aweiland/Diecast-Remote-Raceway/hotwheels-start-gate-model_files/504449-hotwheels-start-gate-9a264b4c-3297-4e25-9e91-c3fe4c538997.pdf

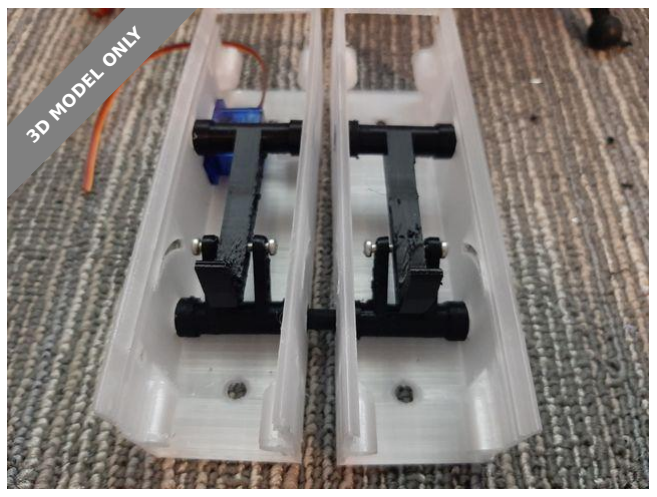
[picture p1: figure]
3D MODEL ONLY

# Summary

Based off of two other projects mostly because I didn't want to by m4

heatset inserts.

Toys & Games (https://printables.com/model?categoryId=30) | > | Vehicles (https://printables.com/model?categoryId=38)
Tags: hotwheelstrack | hotwheels

I made a few changes to a really cool project, take a look at the remote

raceway project.

Changes

Removed the need for M4 heat set inserts, I changed to holes so a M3

bolt with self tap in

I added two screw holes to the lifter, once internal pieces are

installed, tighten the screws and it will make a good connection to the

starter. I found that more than one connection between lanes would

cause binding, So I just use the stick between each of the lifters.

I redesigned the track piece, I prefer the connectors built into the

printed track pieces

I redesigned the front and back plate for a 2 lane setup, makes this

much easier to build if all you make are two lane sets.

I changed the servo mount, now uses a M3x20 set screw.

matthew s (https://printables.com/@matthews)

# Hotwheels start

# gate

VIEW IN BROWSER (https://printables.com/model/504449-hotwheels-start-gate)

updated 13. 6. 2023 | published 13. 6. 2023

1.

2.

3.

4.

5.

# Model files

I changed how it can mount to a Hotwheels mount, I combined the

parts from several Thinginverse Hotwheels clamps in this set.

3mf files showing the print orientation I used.

I have given away each build as birthday presents, so currently don't have

any complete pictures.

# This remix is based on

Diecast Remote Raceway - Starting Gate

by tqmaker (https://www.thingiverse.com/thing:4748087)

The 1/64 Diecast Car n-Lanes Starter Box

by capsurfer (https://www.thingiverse.com/thing:4026846)

Hot Wheels Clamp 3-way

by LukeMurphey (https://www.thingiverse.com/thing:4037458)

print orientation examples | 3 files

6.

7.

clamp-parts.3mf

support-free-parts.3mf build-plate-supported-parts.3mf

mount-to-hotwheels-track-mount.stl

starter.stl

servo-knob.stl

m3-screw-based-lifter.stl

two-lane-back-plate-with-mount.stl

track.stl

servo-box.stl

two-lane-front-plate.stl

# License

This work is licensed under a

Creative Commons (4.0 International License)

Attribution—Noncommercial—Share Alike (http://creativecommons.org/licenses/by-nc-sa/4.0/)

✖ | Sharing without ATTRIBUTION
✔ | Remix Culture allowed
✖ | Commercial Use
✖ | Free Cultural Works
✖ | Meets Open Definition

box.stl

connector_short.stl

hotwheels-clamp.stl

hotwheels-clamp-screw.stl

two-lane-back-cover-no-mount.stl

connector_short.stl
