aweiland/Diecast-Remote-Raceway/hotwheels-start-gate-model_files/print orientation examples/clamp parts.3mf

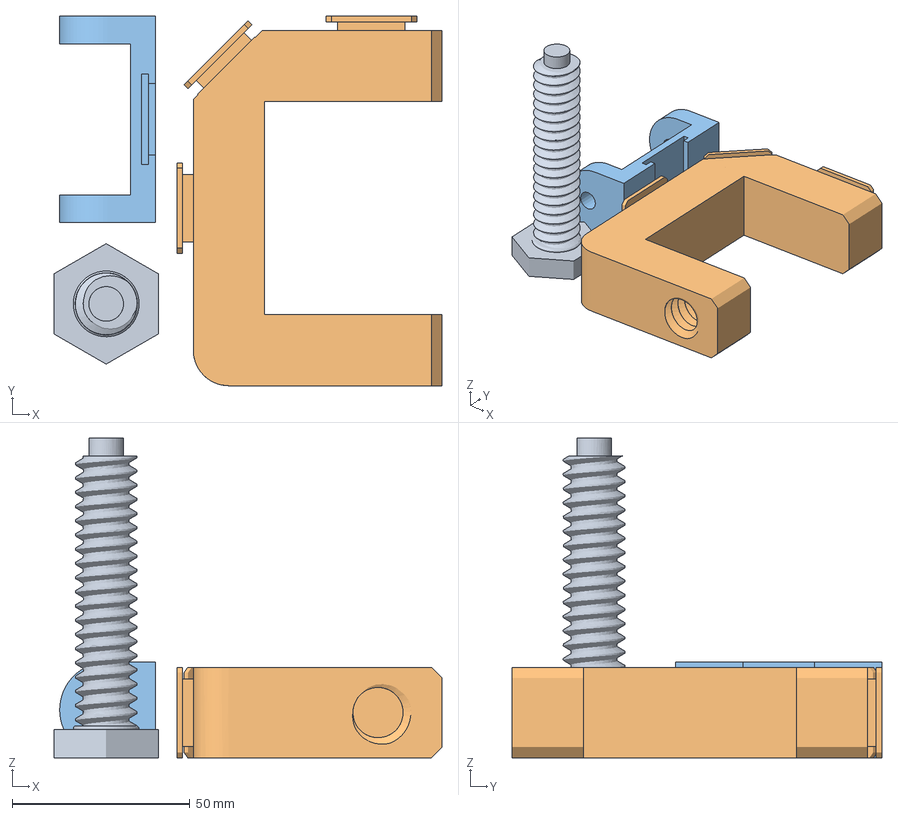
[picture p2: CAD file, 2024-01-16]
hotwheels-start-gate-model_files/print orientation examples/clamp parts.3mf
109.2 x 104.0 x 90.0 mm
hotwheels clamp screw.stl
hotwheels clamp.stl
mount to hotwheels track mount.stl
