aweiland/Diecast-Remote-Raceway/hotwheels-start-gate-model_files/two lane front plate.stl

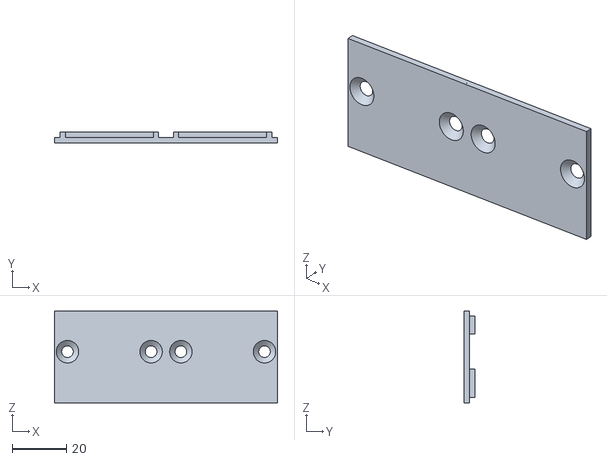
[picture p3: CAD file, 2024-01-16]
hotwheels-start-gate-model_files/two lane front plate.stl
82.4 x 4.00 x 33.9
