aweiland/Diecast-Remote-Raceway/Other/starter.stl

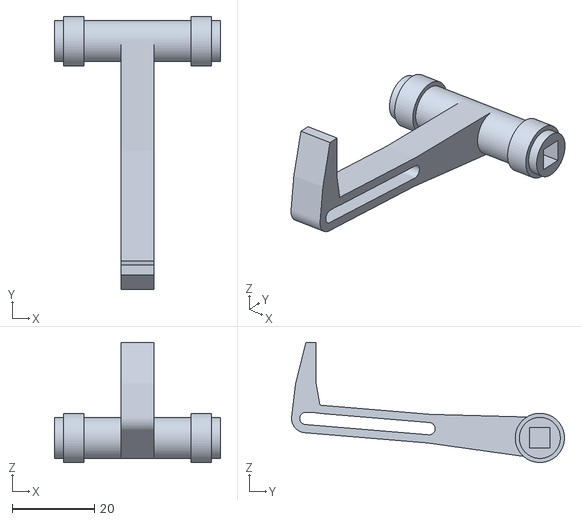
[picture p4: CAD file, 2024-01-16]
Other/starter.stl
40.5 x 66.5 x 29.3
