aweiland/Diecast-Remote-Raceway/hotwheels-start-gate-model_files/print orientation examples/build plate supported parts.3mf

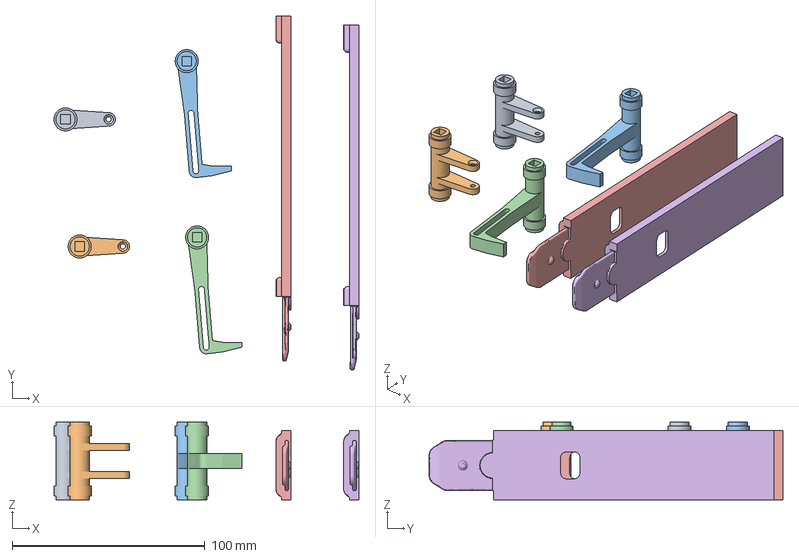
[picture p5: CAD file, 2024-01-16]
hotwheels-start-gate-model_files/print orientation examples/build plate supported parts.3mf
158.4 x 183.7 x 40.5 mm
m3 screw based lifter.stl
starter.stl
track.stl
