aweiland/Diecast-Remote-Raceway/Other/lever.stl

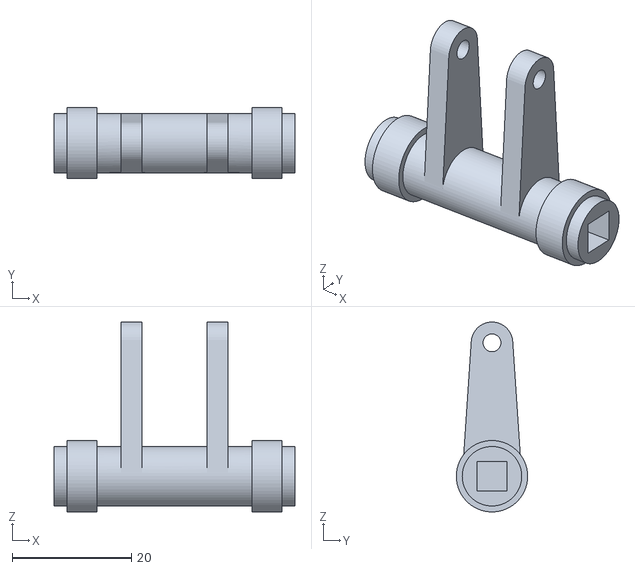
[picture p6: CAD file, 2024-01-16]
Other/lever.stl
40.5 x 12.0 x 31.9
