aweiland/Diecast-Remote-Raceway/hotwheels-start-gate-model_files/mount to hotwheels track mount.stl

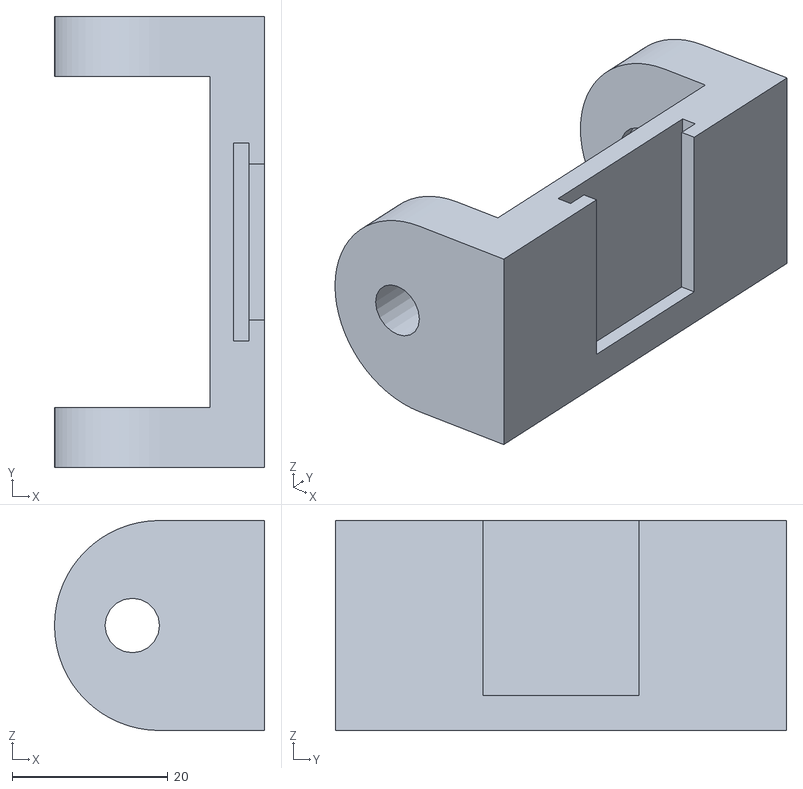
[picture p7: CAD file, 2024-01-16]
hotwheels-start-gate-model_files/mount to hotwheels track mount.stl
27.0 x 58.0 x 27.0
