aweiland/Diecast-Remote-Raceway/hotwheels-start-gate-model_files/print orientation examples/support free parts.3mf

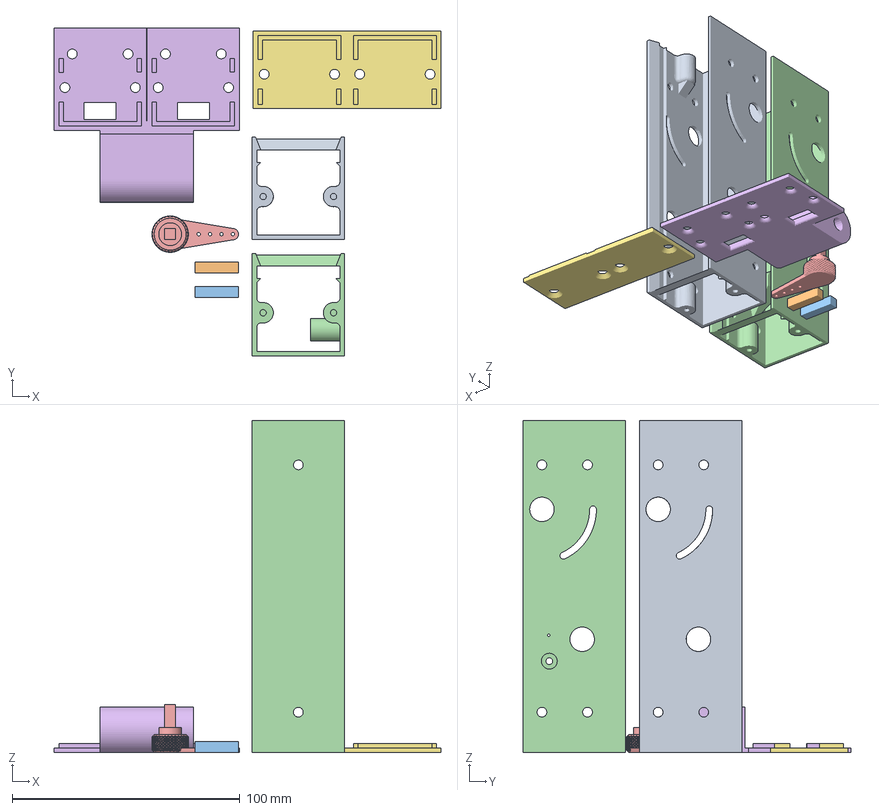
[picture p8: CAD file, 2024-01-16]
hotwheels-start-gate-model_files/print orientation examples/support free parts.3mf
169.8 x 143.8 x 145.7 mm
box.stl
connector_short.stl
servo box.stl
servo knob.stl
two lane back plate with mount.stl
two lane front plate.stl
