aweiland/Diecast-Remote-Raceway/Other/lid_v2.stl

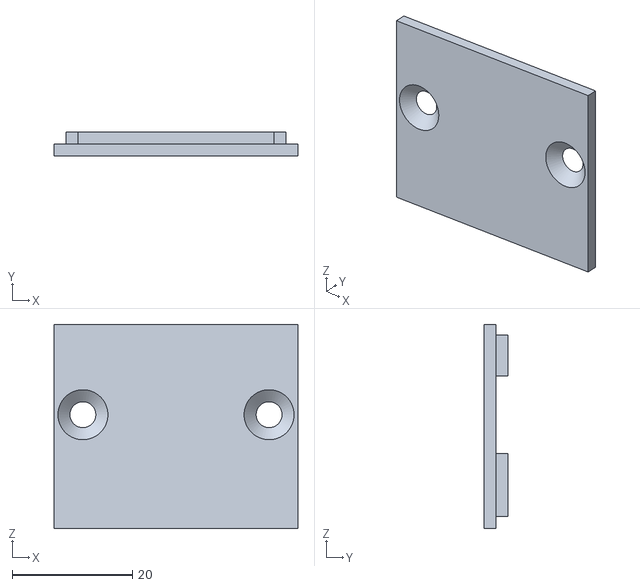
[picture p9: CAD file, 2024-01-16]
Other/lid_v2.stl
40.5 x 4.00 x 33.9
