aweiland/Diecast-Remote-Raceway/hotwheels-start-gate-model_files/connector_short.stl

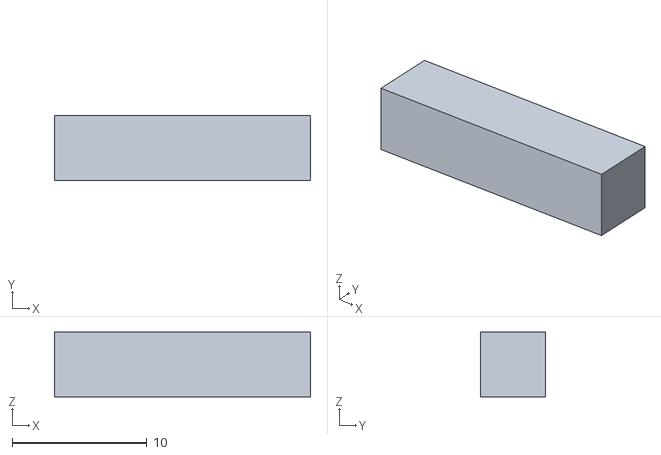
[picture p10: CAD file, 2024-01-16]
hotwheels-start-gate-model_files/connector_short.stl
19.0 x 4.80 x 4.80
