aweiland/Diecast-Remote-Raceway/Other/connector_v2.stl

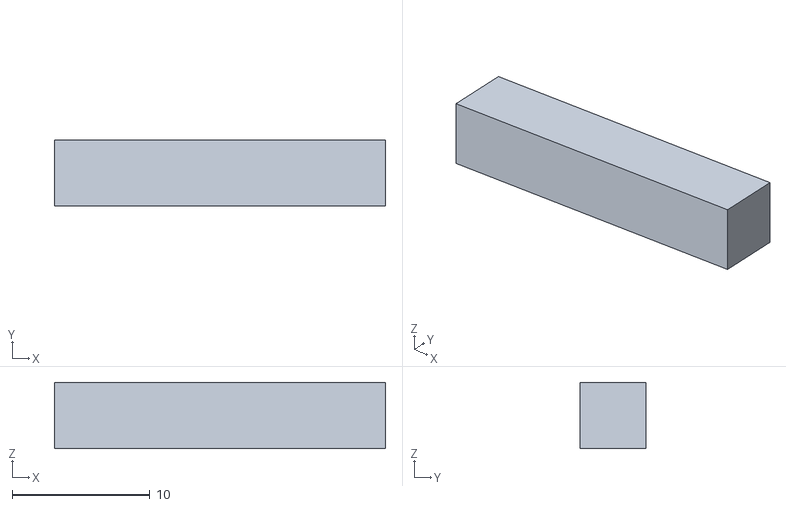
[picture p11: CAD file, 2024-01-16]
Other/connector_v2.stl
24.0 x 4.80 x 4.80
