aweiland/Diecast-Remote-Raceway/hotwheels-start-gate-model_files/hotwheels clamp.stl

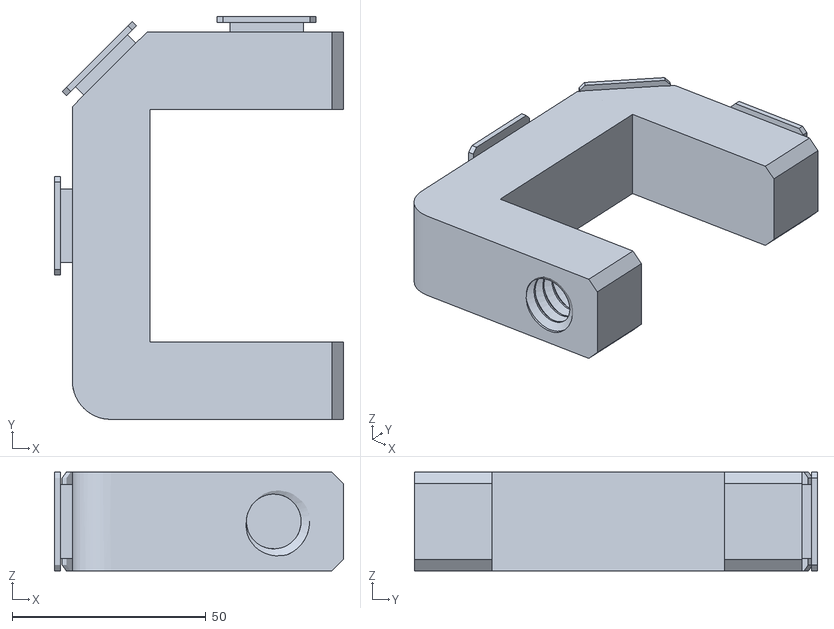
[picture p12: CAD file, 2024-01-16]
hotwheels-start-gate-model_files/hotwheels clamp.stl
74.6 x 104.0 x 25.5
