aweiland/Diecast-Remote-Raceway/Other/thestick_long4.stl

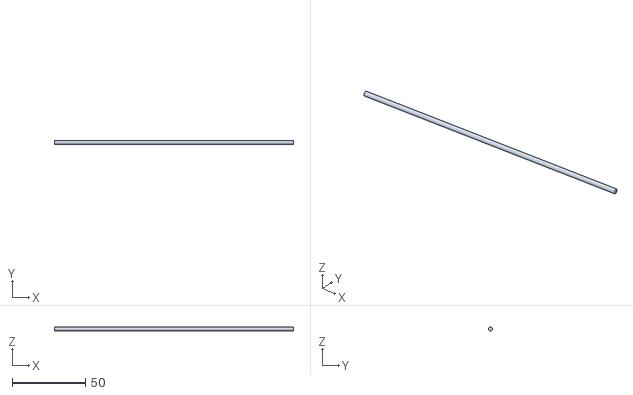
[picture p13: CAD file, 2024-01-16]
Other/thestick_long4.stl
163.0 x 2.70 x 2.70
