aweiland/Diecast-Remote-Raceway/Other/pisugar_case_lcd_button_comp.STL

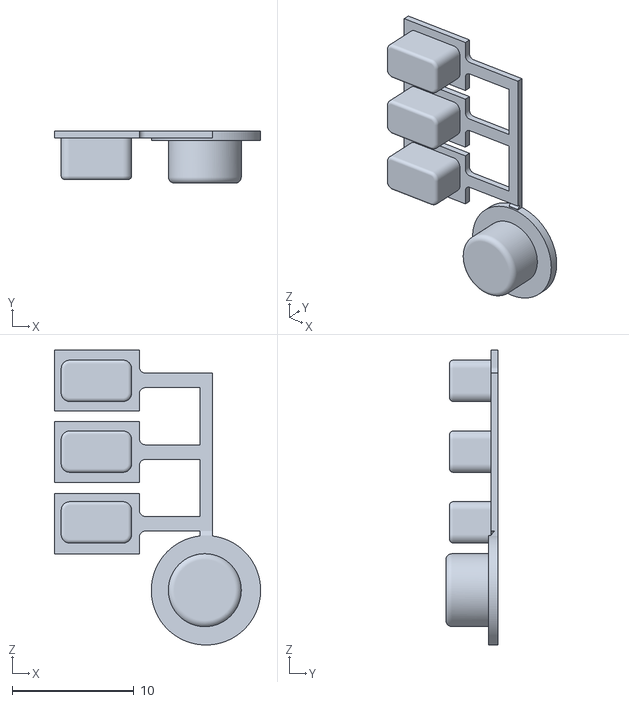
[picture p14: CAD file, 2024-01-16]
Other/pisugar_case_lcd_button_comp.STL
17.0 x 4.30 x 24.3
