aweiland/Diecast-Remote-Raceway/hotwheels-start-gate-model_files/two lane back plate with mount.stl

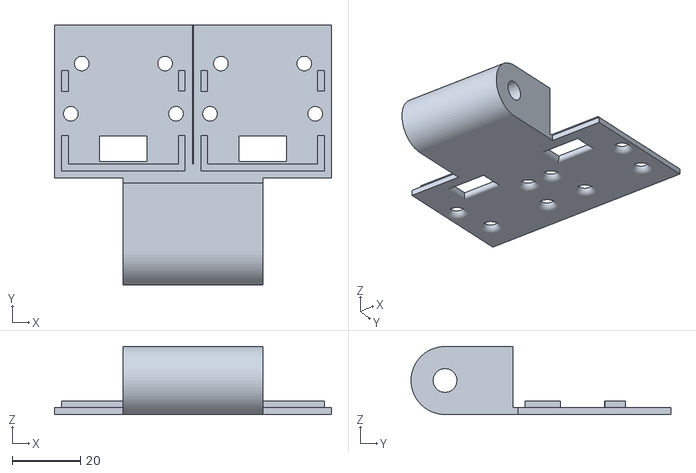
[picture p15: CAD file, 2024-01-16]
hotwheels-start-gate-model_files/two lane back plate with mount.stl
81.4 x 76.4 x 20.0
