aweiland/Diecast-Remote-Raceway/hotwheels-start-gate-model_files/two lane back cover no mount.stl

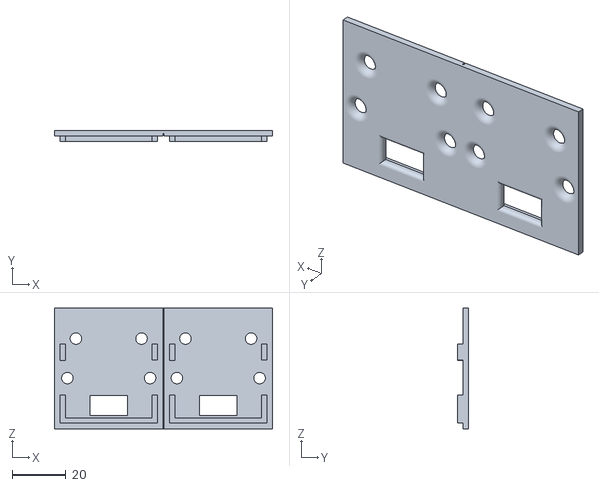
[picture p16: CAD file, 2024-01-16]
hotwheels-start-gate-model_files/two lane back cover no mount.stl
81.4 x 4.00 x 45.0
