aweiland/Diecast-Remote-Raceway/hotwheels-start-gate-model_files/servo box.stl

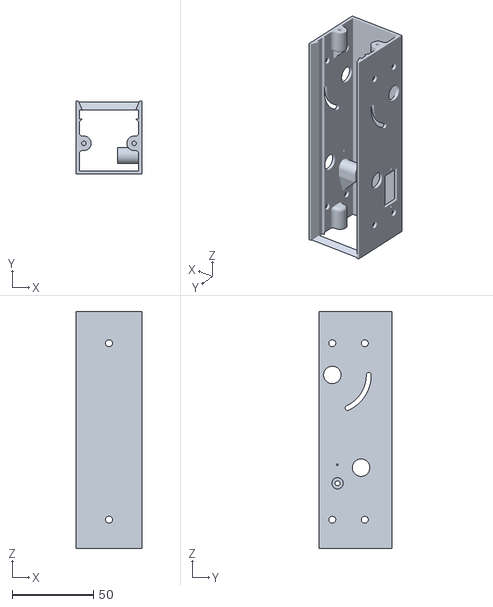
[picture p17: CAD file, 2024-01-16]
hotwheels-start-gate-model_files/servo box.stl
40.5 x 45.0 x 145.7
