aweiland/Diecast-Remote-Raceway/hotwheels-start-gate-model_files/track.stl

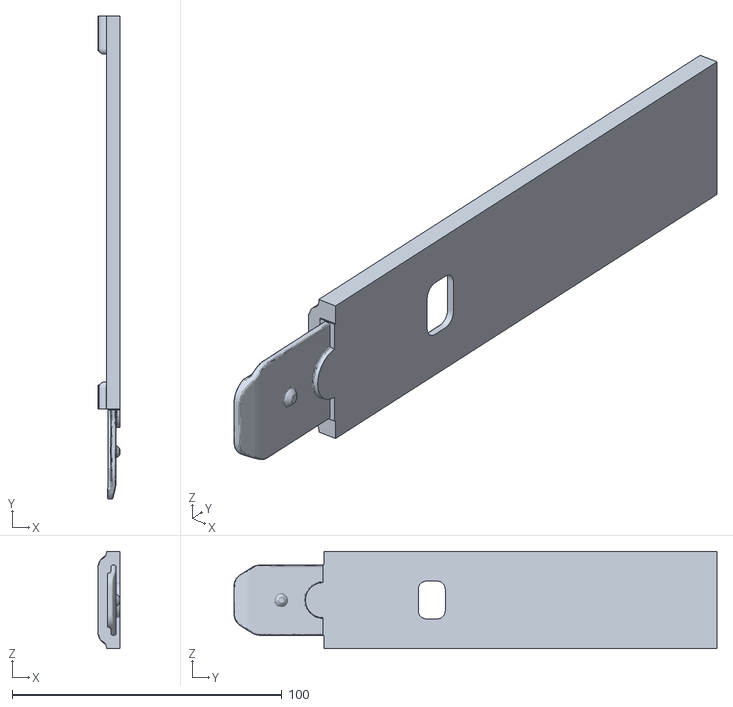
[picture p18: CAD file, 2024-01-16]
hotwheels-start-gate-model_files/track.stl
8.00 x 179.0 x 36.0
