aweiland/Diecast-Remote-Raceway/hotwheels-start-gate-model_files/box.stl

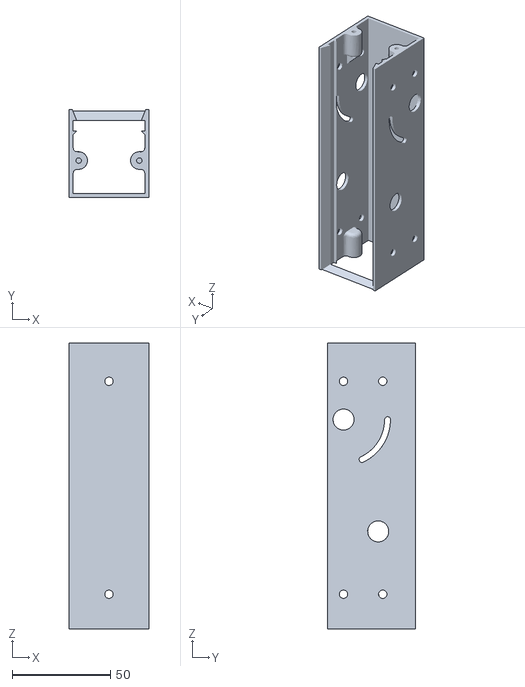
[picture p19: CAD file, 2024-01-16]
hotwheels-start-gate-model_files/box.stl
40.5 x 45.0 x 145.7
