aweiland/Diecast-Remote-Raceway/hotwheels-start-gate-model_files/servo knob.stl

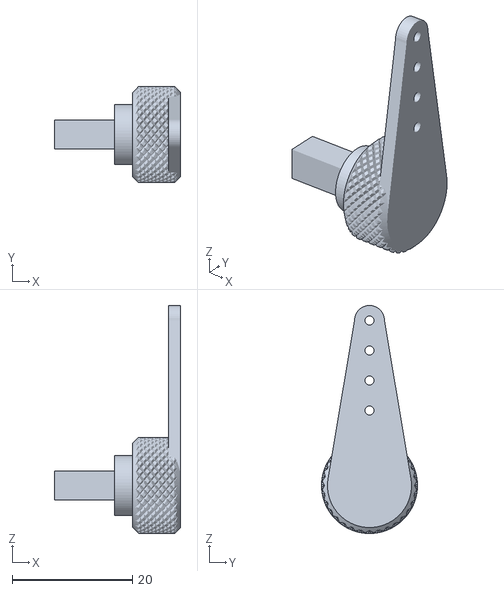
[picture p20: CAD file, 2024-01-16]
hotwheels-start-gate-model_files/servo knob.stl
21.0 x 16.0 x 38.0
