aweiland/Diecast-Remote-Raceway/(list of files, cad)

Other CAD files:
hotwheels-start-gate-model_files/hotwheels clamp screw.stl
hotwheels-start-gate-model_files/m3 screw based lifter.stl
