aweiland/Diecast-Remote-Raceway/(commit log)

2024-01-21 Fixes and updating readme
    [display.py, drr_wrapper.py]
2024-01-23 Fixed first draw race condition
    [display.py, starting_gate.py]
2024-02-11 More track states
